sidberg/gofaster/3d/39-29-4069.stp

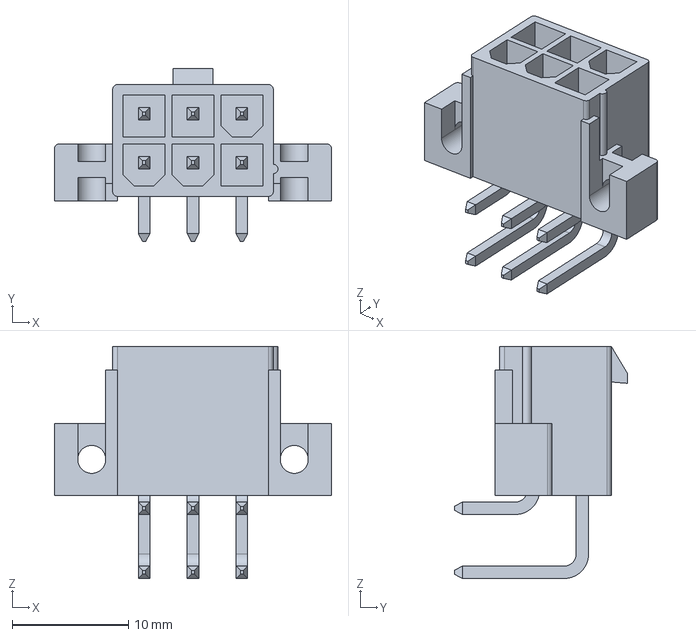
[picture p1: CAD file, 2024-07-01]
3d/39-29-4069.stp
23.8 x 14.9 x 19.9 mm
