sidberg/gofaster/case/gofaster-lid.step

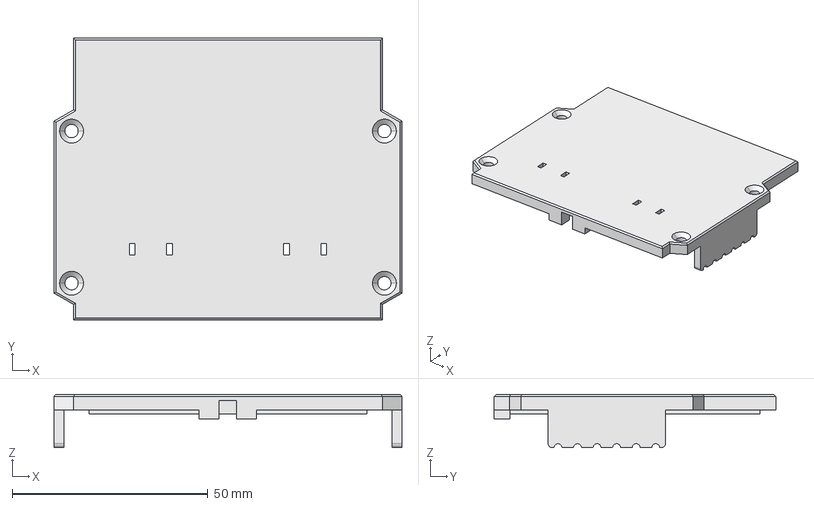
[picture p2: CAD file, 2025-02-20]
case/gofaster-lid.step
89.0 x 72.0 x 13.6 mm
