sidberg/gofaster/3d/CUI_DEVICES_TB002-500-06BE.step

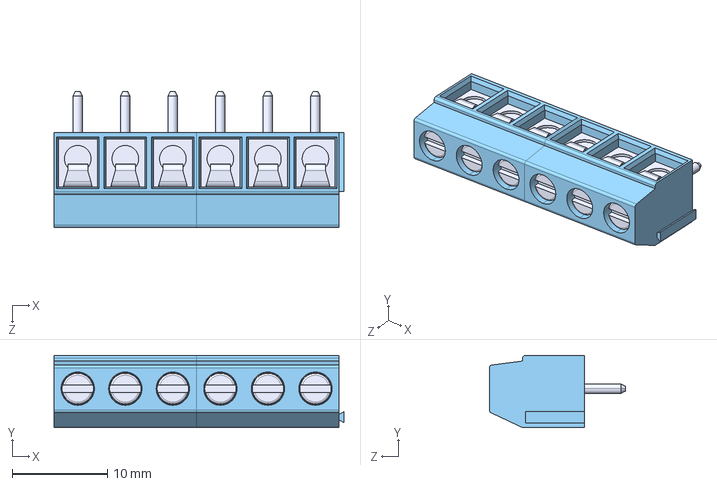
[picture p3: CAD file, 2024-07-01]
3d/CUI_DEVICES_TB002-500-06BE.step
30.5 x 7.60 x 14.4 mm
TB002-500-03P_Blue - S x 2
