sidberg/gofaster/3d/PBH2UEEKZXNAG1RBLK.stp

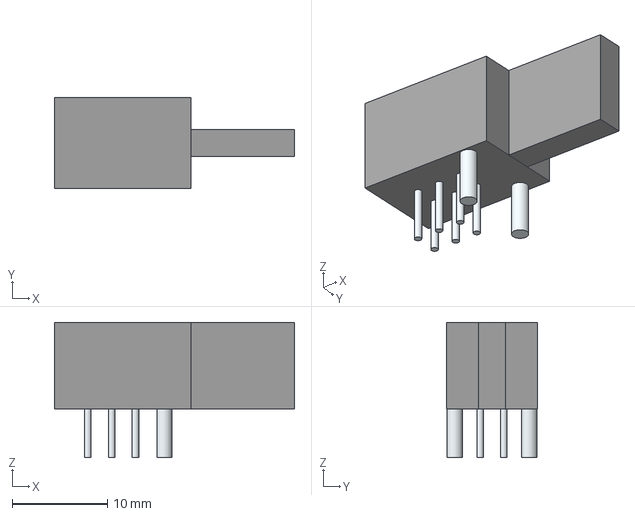
[picture p4: CAD file, 2024-07-01]
3d/PBH2UEEKZXNAG1RBLK.stp
25.2 x 9.60 x 14.2 mm
Leads
