sidberg/gofaster/case/case.step

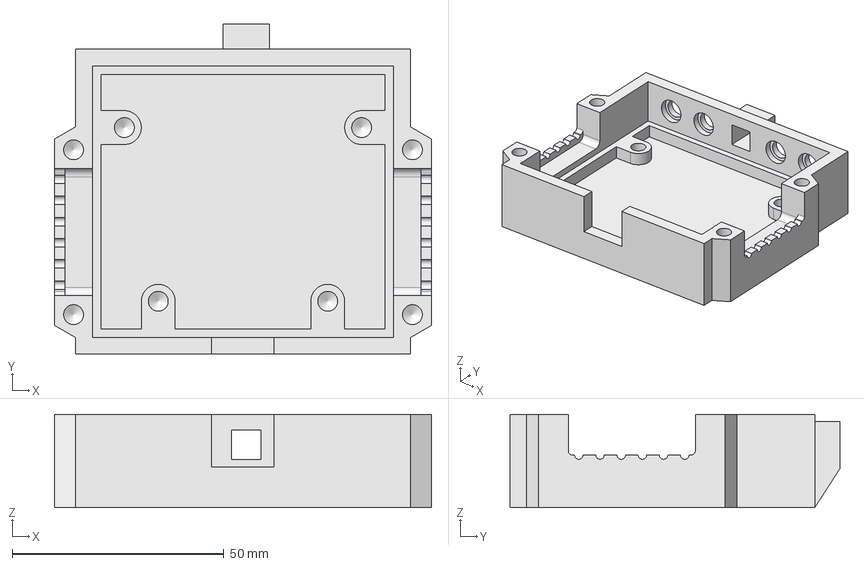
[picture p5: CAD file, 2025-02-20]
case/case.step
89.0 x 78.0 x 22.0 mm
