sidberg/gofaster/3d/3306K001.stp

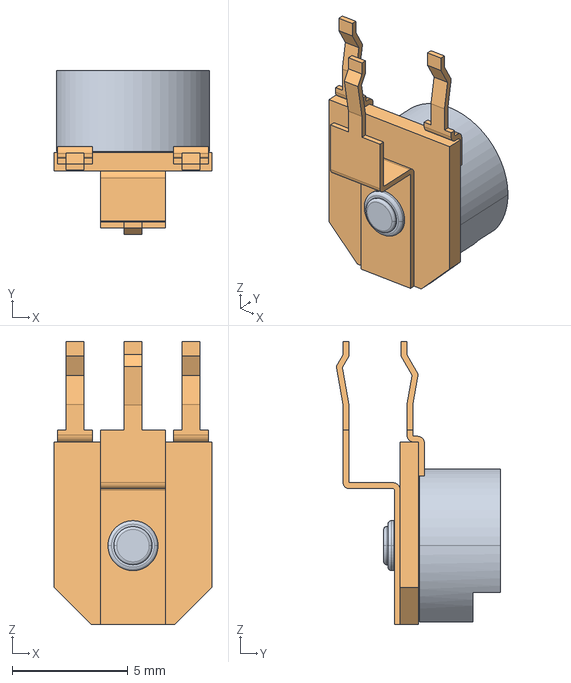
[picture p6: CAD file, 2024-07-01]
3d/3306K001.stp
6.81 x 7.10 x 12.2 mm
