sidberg/gofaster/(list of files, cad)

Other CAD files:
case/gofaster.FCStd
