sidberg/gofaster/gofaster.kicad_pcb

## KiCad design gofaster.kicad_pcb (2024-07-01)

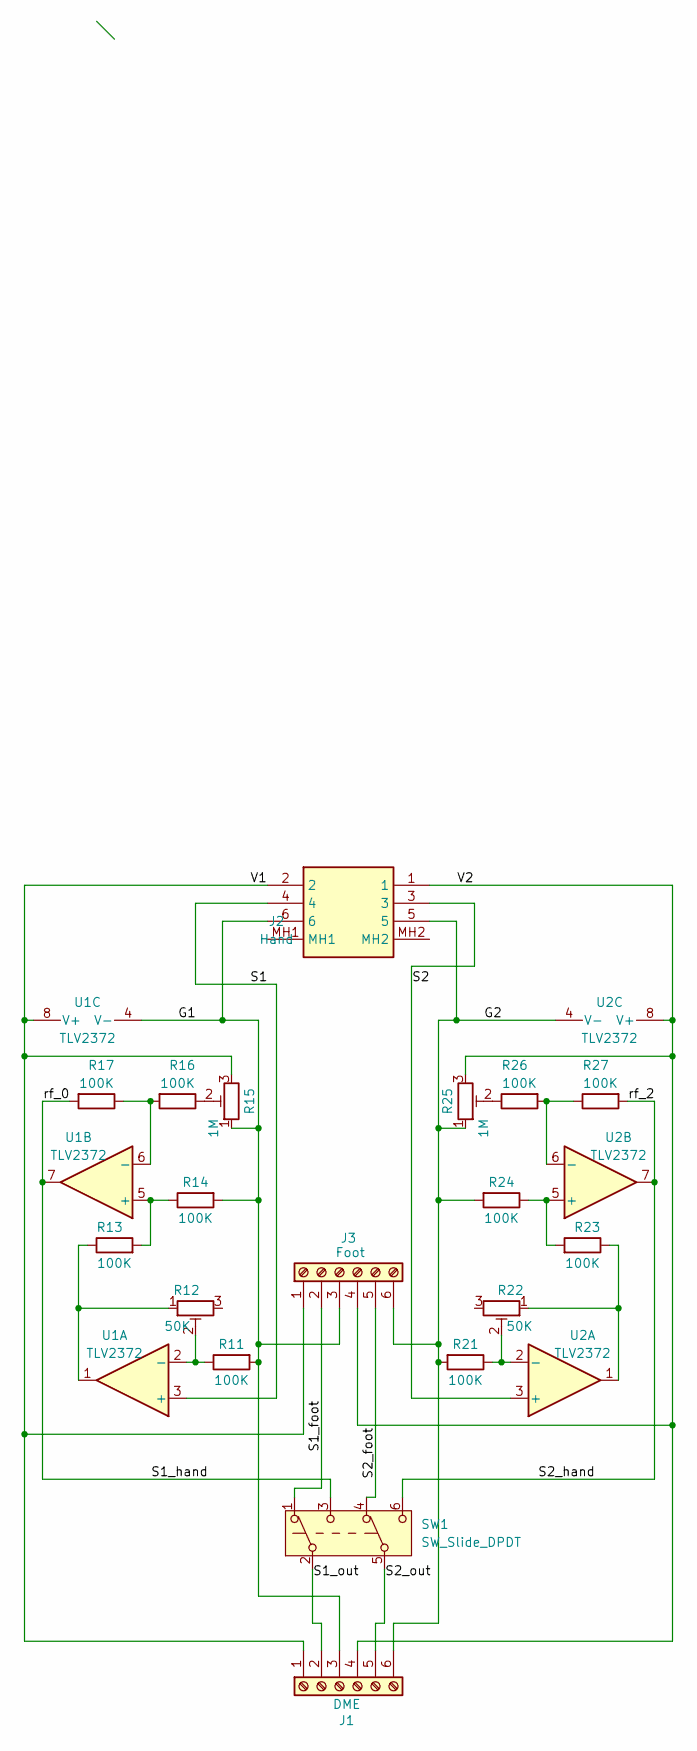
[picture p7: schematic gofaster.kicad_sch, BMW Auxiliary Accelerator Adapter]

Parts:
J1: DME; CUI_TB002-500-06BE
J2: Hand; 39294069; Mouser Part Number 538-39-29-4069
J3: Foot; CUI_TB002-500-06BE
R11, R13, R14, R16, R17, R21, R23, R24, R26, R27: 100K; R_Axial_DIN0207_L6.3mm_D2.5mm_P7.62mm_Horizontal
R12, R22: 50K; Potentiometer_Bourns_3339S_Horizontal
R15, R25: 1M; Potentiometer_Bourns_3339S_Horizontal
SW1: SW_Slide_DPDT; PBH2UEEKZXNAG1RBLK
U1, U2: TLV2372; DIP-8_W7.62mm

Connections:
/G1: J1.3, J2.6, J3.3, R11.2, R14.2, R15.1, U1.4 (V-)
/G2: J1.6, J2.5, J3.6, R21.2, R24.2, R25.1, U2.4 (V-)
/S1: J2.4, U1.3 (+)
/S1_foot: J3.2, SW1.1 (A)
/S1_hand: R17.2, SW1.3 (C), U1.7
/S1_out: J1.2, SW1.2 (B)
/S2: J2.3, U2.3 (+)
/S2_foot: J3.5, SW1.4 (A)
/S2_hand: R27.2, SW1.6 (C), U2.7
/S2_out: J1.5, SW1.5 (B)
/V1: J1.1, J2.2, J3.1, R15.3, U1.8 (V+)
/V2: J1.4, J2.1, J3.4, R25.3, U2.8 (V+)
unnamed: R12.1, R13.1, U1.1
unnamed: R15.2, R16.1
unnamed: R22.1, R23.1, U2.1
unnamed: R25.2, R26.1
unnamed: R11.1, R12.2, U1.2 (-)
unnamed: R13.2, R14.1, U1.5 (+)
unnamed: R16.2, R17.1, U1.6 (-)
unnamed: R21.1, R22.2, U2.2 (-)
unnamed: R23.2, R24.1, U2.5 (+)
unnamed: R26.2, R27.1, U2.6 (-)

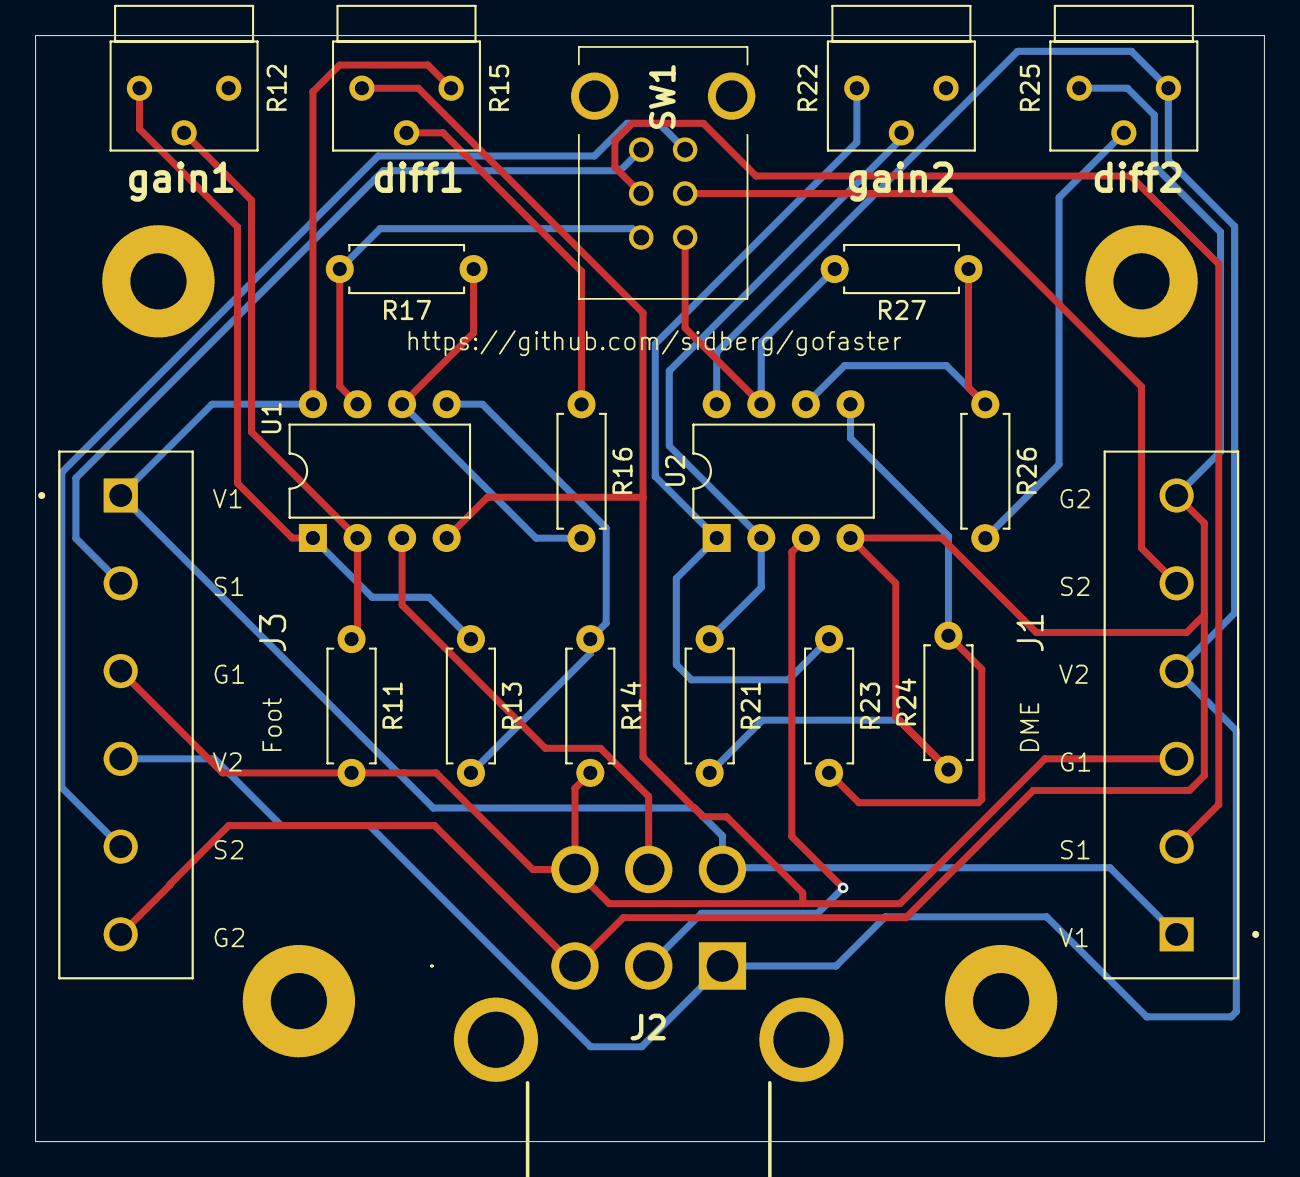
[picture p8: board gofaster.kicad_pcb from above]

Board: 2 copper layers, 70.0 x 63.0 mm, 20 parts (0 on the bottom side), 22 nets.
