sidberg/gofaster/(commit log)

2024-07-08 remove gerbers
    [gofaster-B_Cu.gbl, gofaster-B_Mask.gbs, gofaster-B_Paste.gbp, gofaster-B_Silkscreen.gbo, gofaster-Edge_Cuts.gm1, gofaster-F_Cu.gtl, gofaster-F_Mask.gts, gofaster-F_Paste.gtp]
2025-02-20 add enclosure
    [button.step, case.step, gofaster-lid.step, gofaster.FCStd]
